jesrockr/stm32_f9p_gnss_rover_logger/assets/boot.jpg

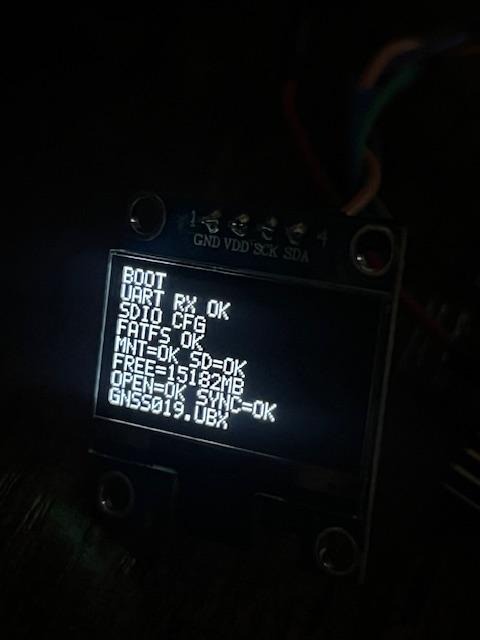
assets/boot.jpg
