jesrockr/stm32_f9p_gnss_rover_logger/assets/log.jpg

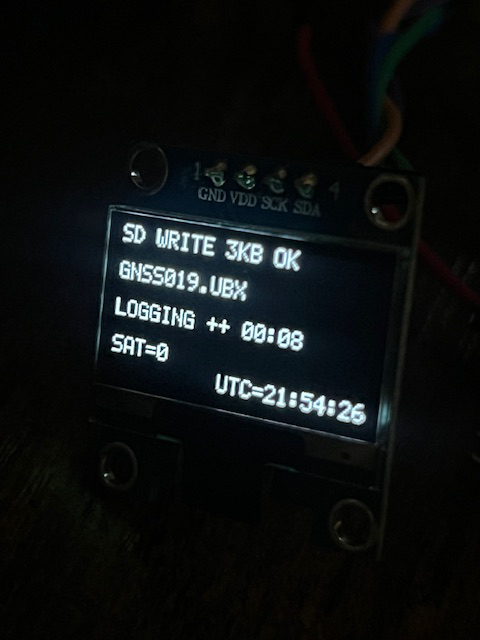
assets/log.jpg
