jesrockr/stm32_f9p_gnss_rover_logger/assets/rodheight.jpg

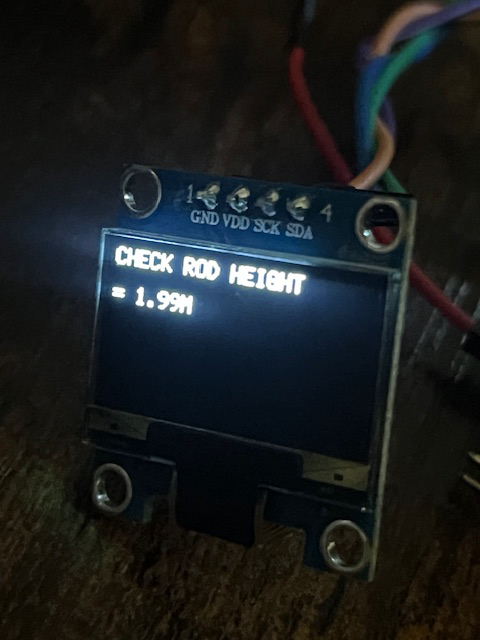
assets/rodheight.jpg
