jesrockr/stm32_f9p_gnss_rover_logger/assets/sdcard.png

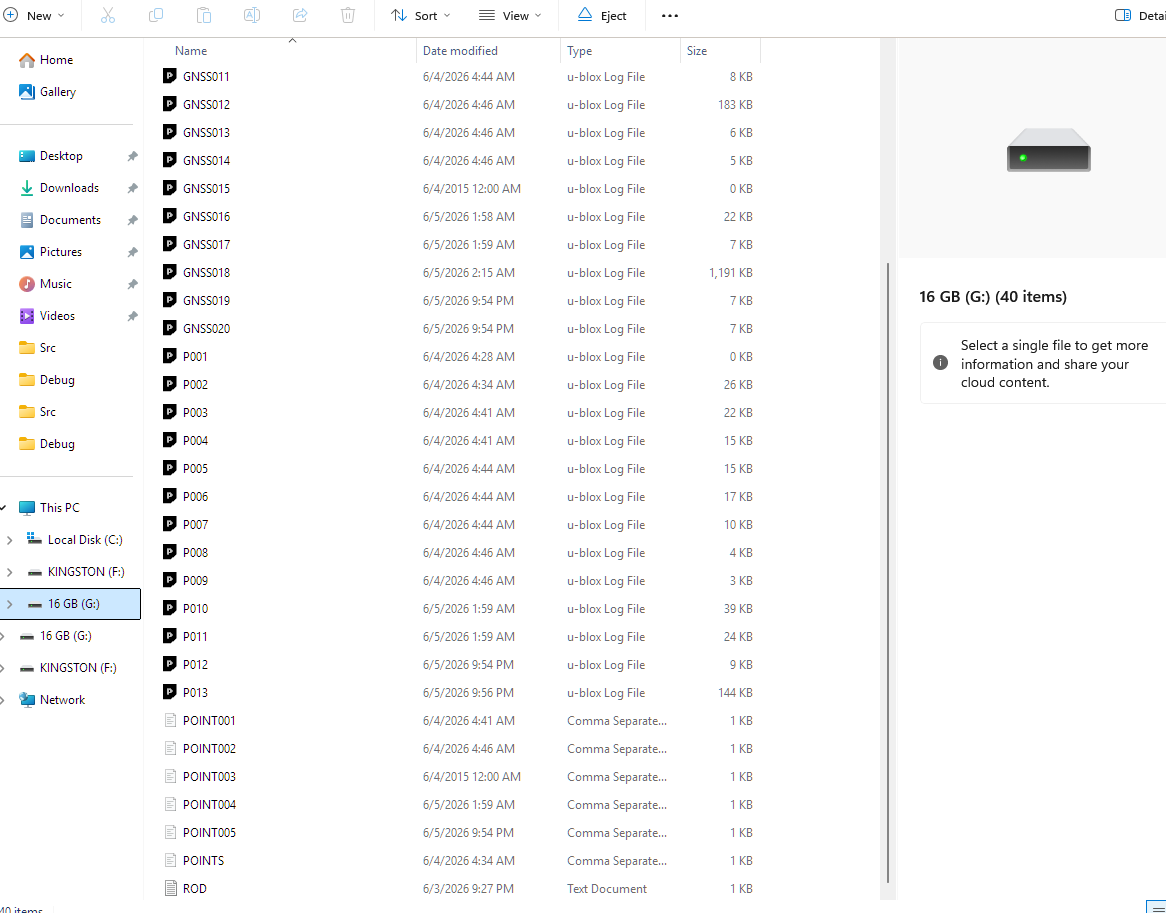
assets/sdcard.png
