jesrockr/stm32_f9p_gnss_rover_logger/assets/store point.jpg

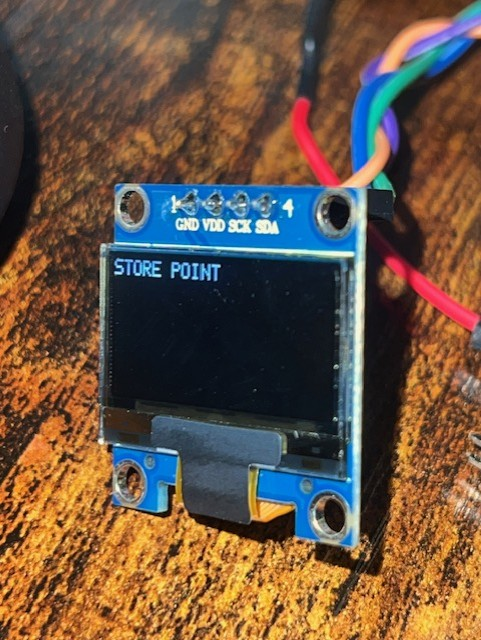
assets/store point.jpg
