jesrockr/stm32_f9p_gnss_rover_logger/TODO.md

# TODO

- Release ANDROID companion app that provides live map, gnss status, and detects button presses for storing points (SWMaps lacks this ability)
- Optionally warn or refuse point storage unless `carrier=2`.
- Add documentation screenshots/photos.
- Add wiring diagram.
- Add sample CSV output.
- Add troubleshooting guide.
- Add license and GitHub issue templates.
