jesrockr/stm32_f9p_gnss_rover_logger/(commit log)

2026-06-05 Rename rod height.jpg to rodheight.jpg
2026-06-13 Rename STM32 FRONT.avif to STM32.avif
